jonathanw82/HydroBigTent/README.md

<h1 align="center">
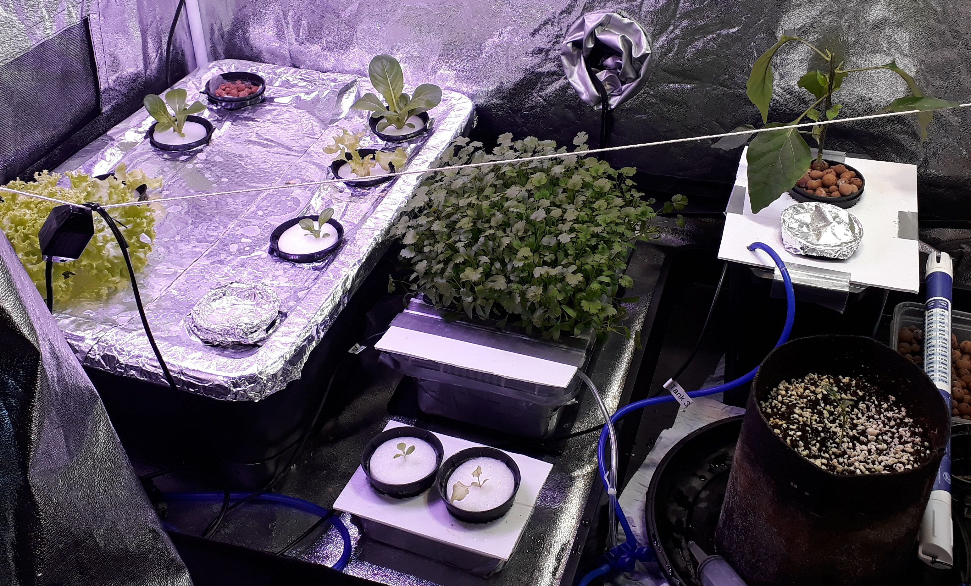
[picture p1: images/hydro1.jpg]
Hydro image
   
 </h1>
 
## Hydroponics

### I hold this project close to my heart, as it was my very first venture into coding, undertaken without any previous knowledge. The entire learning process, fueled by a book and Google, truly demonstrates how far I've advanced in my coding career from those initial steps to where I am today.

I created this Hydroponics system out of my love of mixing technology with nature, the ability to harness the building blocks of life to create tasty food in my dining room. This project is a work in progress but I am proud of the evolution of it.

The heart of the system is an Arduino Uno, connected to a real-time clock module, an LCD display and a rotary encoder. The Arduino controls lighting cycles, monitors water temperatures turning heat mats on if the water temperature is below its designated temperature. Whilst also keeping an eye on the time in case watering intervals have been reached and turning on pumps as necessary. The system can handle NFT and Ebb and flow style systems. During the creation of the system, I have made it able to have 2 tents with 2 individual lights that can be set to their own time cycles. The incorporation of a menu system and using EEprom to save settings was also implemented at this time.

When I first created the system, I originally used a compact fluorescent light, but I found if chews too much power to lumen ratio, I also tried to run the lights of a solid-state relay however being florescent, the solid-state relay made if flicker even when it was off, due to the way solid-state relay has a small but normal current flow through them that slowly charges up the capacitors in the fluorescent bulbs ballast and when they get to their minimum stating voltage the bulb with try to start but then die back dimply. To get around this, I used a standard relay, but due to the inrush current being 100+ times the operating current, the florescent bulb would fuse the relay terminals together not allowing the bulb to turn off, I even tried putting a snubber across the terminals but to no avail. At this point, I decided to go with a contractor as it is rated well over any spike in current the bulb could produce. Soon after, the florescent was replaced with the led bulbs in the second lighting fixture created out of individual bulbs that can be added or removed depending on the light intensity I needed for that particular application. More on lighting can be found here [Lighting](#lighting)

#### The user's goals of this system are:
* An easy to navigate menu
* Low power consumption
* Zero landfill
* Create great food fast

#### I think this system gives this to the user because:
* The rotary encoder is easy to use with one button click.
* The display cycles through current realtime data such as temperature and humidity.
* The entire system only takes 210 watts max.
* The system can use multiple types of hydroponic platforms such as Deep Water Culture, Nutrient Film Technique, Ebb and Flow etc.
* Due to the use of pool noodles, jiffy's, net cups, clay pebbles and coco, there is no Rockwool so zero landfill.

 ## Features:
* Rotary encoder for navigation
* Lcd display for easy and real-time data
* Realtime clock
* Led lights
* Silent running cooling fans
* Large quiet extractor fan [goto](#air-extraction)
* Silent running circulation fans
* Quiet air pump [goto](#air-pumps)
 
<div align="center">
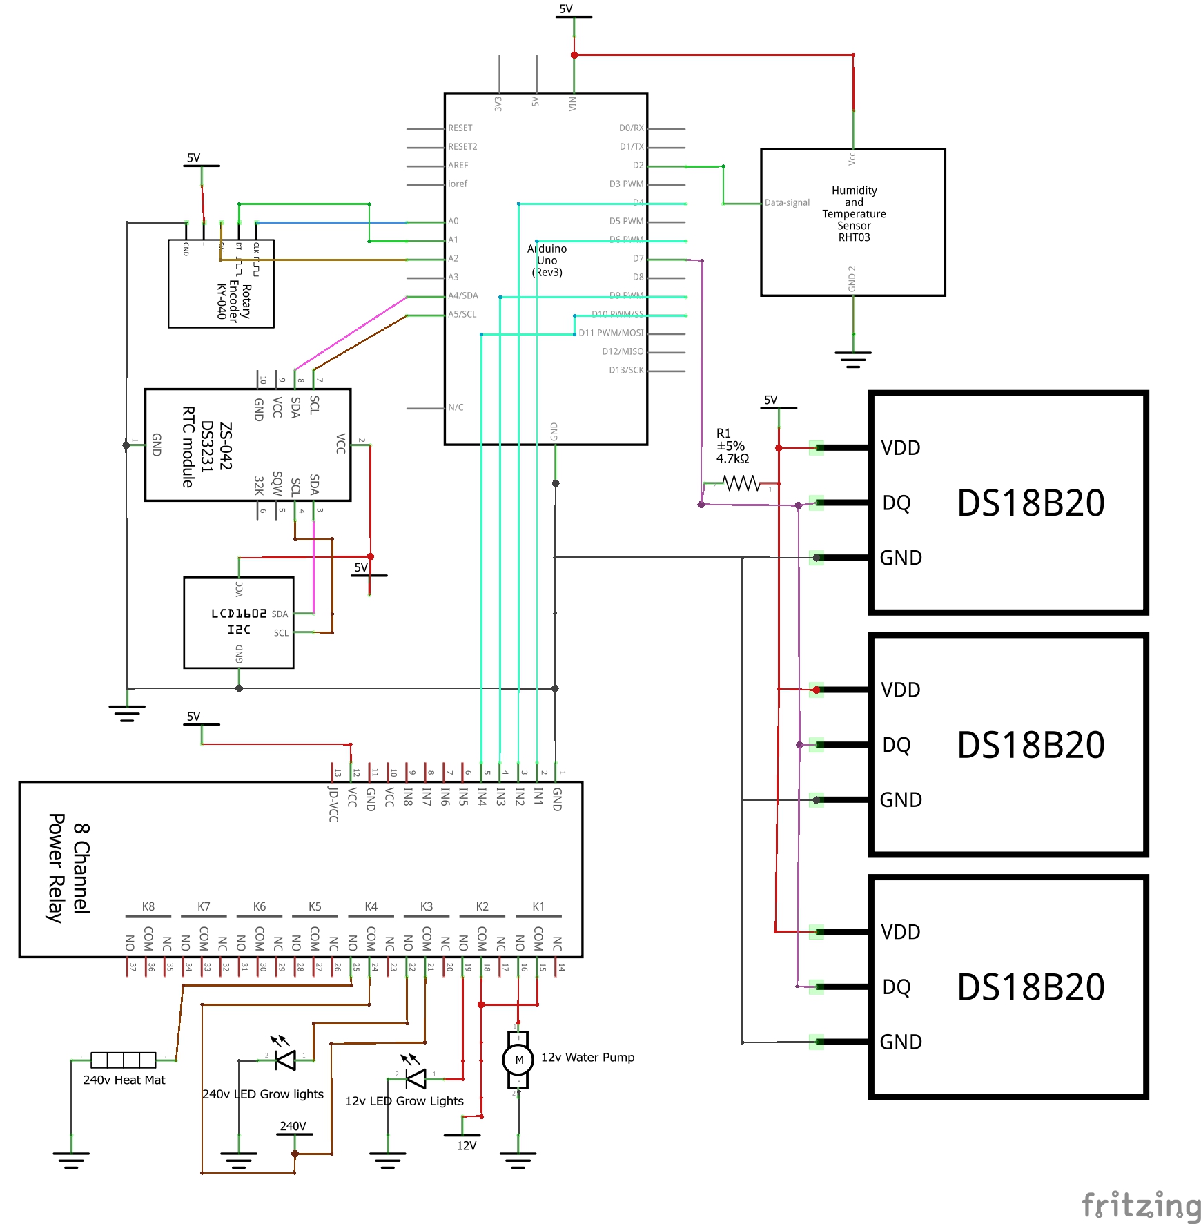
[picture p2: images/hydro_schem.jpg]
wireing diagram
   </div>

## Parts:
* 1x Arduino Uno (Rev3) [here](https://store.arduino.cc/arduino-uno-rev3)
* 1x RHT03 Humidity Temp Sensor [here](https://www.banggood.com/AM2302-DHT22-Temperature-And-Humidity-Sensor-Module-p-937403.html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)
* 3x DS18B20 Water temp sensors [here](https://www.cricklewoodelectronics.com/Waterproof-Digital-Temperature-Probe-for-Arduino-DS18B20.html) Unfortunatly there are not the ones in use currently.
* 1x KY-040 Rotery Encoder [here](https://www.cricklewoodelectronics.com/Rotary-encoder-module-for-Arduino-KY-040.html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) 
* 1x Lcd 1602i2c Display [here](https://create.arduino.cc/projecthub/Oniichan_is_ded/lcd-i2c-tutorial-664e5a)
* 1x Real Time clock Modual [here](https://uk.banggood.com/DS3231-AT24C32-IIC-Precision-RTC-Real-Time-Clock-Memory-Module-p-1547989.html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)
* 1x 4 channel realy [here](https://cpc.farnell.com/velleman-kit/vma400/4-channel-relay-module-for-arduino/dp/SC14419?mckv=sA419NTjI_dc|pcrid|224679642167|kword||match||plid||slid||product|SC14419|pgrid|47129782516|ptaid|pla-371255952663|&CMP=KNC-GUK-CPC-SHOPPING&gclid=EAIaIQobChMIssm7n_fl6QIVj-vtCh0o4Af9EAQYBSABEgLoQPD_BwE)
* 1x Contactor CUC20 [here](https://www.screwfix.com/p/british-general-20a-dp-contactor/6654p?_requestid=594347)
* 1x 5v 30amp Relay [here](https://robotdyn.com/relay-module-1-relay-5v-30a.html)
* 1x RK100 Can-fan [here](http://www.canfan.nl/cfrk100.html)
* 1x Acoustic air ducting [here](https://www.electrical2go.co.uk/insulated-aluminium-ducting-100mm-x-10m-fxalins-100.html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)
* 1x Grow tent
* 1x Eheim air pump 400 [here](https://www.eheim.com/en_GB/products/technology/air-pumps/air-400)
* 6x golf ball air stones and pipe.
* 25x growsun 3w Full spaectrum 380nm-840nm Led Chips [here](https://www.banggood.com/3W-380nm-840nm-Full-Spectrum-LED-Plant-Grow-Light-Chip-for-Garden-3_0-3_4V-p-1060934.html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)
* 15x High Power Led Chip 3W Cool White 3000K-3500K chips [here](https://www.lightinthebox.com/en/p/diy-3w-high-power-220-240lm-warm-white-light-led-module-3-2-3-6v-15pcs_p1549727.html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)
* 3x Noise Blocker 140mm fans [here](https://www.blacknoise.com/site/en/products/noiseblocker-it-fans/nb-eloop-series/120x120x25mm.php?lang=EN)

## Recycled parts:
* 1x 240v to 110v Auto Transformer [here](https://mcitransformer.com/product/mci-4-49-series/) From an old video game.
* 1x S-150-12 Switch mode power supply [here](https://uk.rs-online.com/web/p/embedded-switch-mode-power-supplies-smps/6210663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) from an old video game.
* 1x RD-65A Switch mode power supply [here](https://uk.rs-online.com/web/p/embedded-switch-mode-power-supplies-smps/6447102/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) From an old video game.
* 1x Aluminium sheet from the contol unit of a scap 2 penny pusher.
* 1x Heatsink from an old sega daytona video game graphics card.
* 2x storage boxes.
* Variouse other parts.

## Lcd Display:
<div align="center">
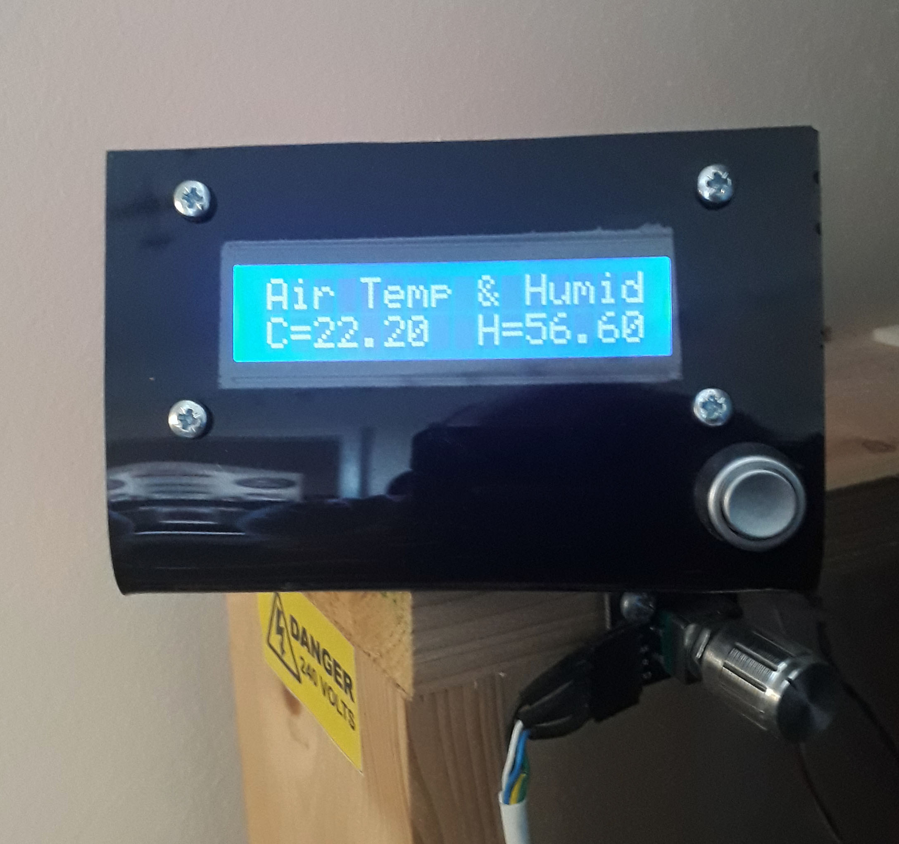
[picture p3: images/lcd.jpg]
topof image
</div>

#
During day to day running the LCD display scrolls through a few screens of data including
* Time and date 
* Air temperature and humidity
* The big tank water temperature
* Tank 2 water temperature
* Tank 3 water temperature
* Heat pad status
* Light cycle for the 12v led panel
* Light cycle for the 240v led bulbs

### Setup program flow:
On pressing the rotary encoder centre button
* Lighting time 240v lights, on click, will give a menu allowing selection of 0, 12, 14, 16, 18 hours duration.
* Lighting time 12v lights, on click, will give a menu allowing selection of 0, 12, 14, 16, 18 hours duration.
* Watering duration, on click, will give a menu allowing selection of between 5 and 90 seconds in 0.5 increments duration.
* Watering time, on click, will give a menu allowing selection of auto water off, or if rotated to the right you can select what hour you would like to start watering. If at the auto water off selection if the encoder is rotated further left a selection to turn on NFT will appear. Further adjustment to NFT can be done in the next menu.
* NFT with cycle, on click, will give a menu allowing selection of on duration and off duration in minutes.
* Manual water, on click, will give a menu allowing selection manual overriding the water pump, in case of now plants needing an initial dousing of nutrient feed.
* Daylight saving, on click, will give a menu allowing selection of plus or minus 1 hour. This only affects the clock on the LCD display and will not change the global watering or lighting cycles due to some plants being sensitive to changes in lighting durations.
* Heat pad temperature settings, on click, will give a menu allowing the max temperate of the heat mate from 0 to 25 degrease centigrade.
* Exit menu
* If the centre button on the encoder is held down it will cause the Arduino to rest by kicking the watchdog, this can be done regardless of being in setup mode.

## Lighting
The 12v lighting panel was made up of a piece of aluminium from the lid of a 2 penny pusher control box, with a heat sink from a Sega Daytona video game and stuck to the top with thermal glue. At first, I wanted the cooling to be passive, but there were too many led chips in close proximity, so I had to add a fan, most of the early fans I used were really loud or vibrated too much, so I added a noise blocker fan as they produce 178.3 m3/h @28.5db so it was a good compromise.   
#
<div align="center">
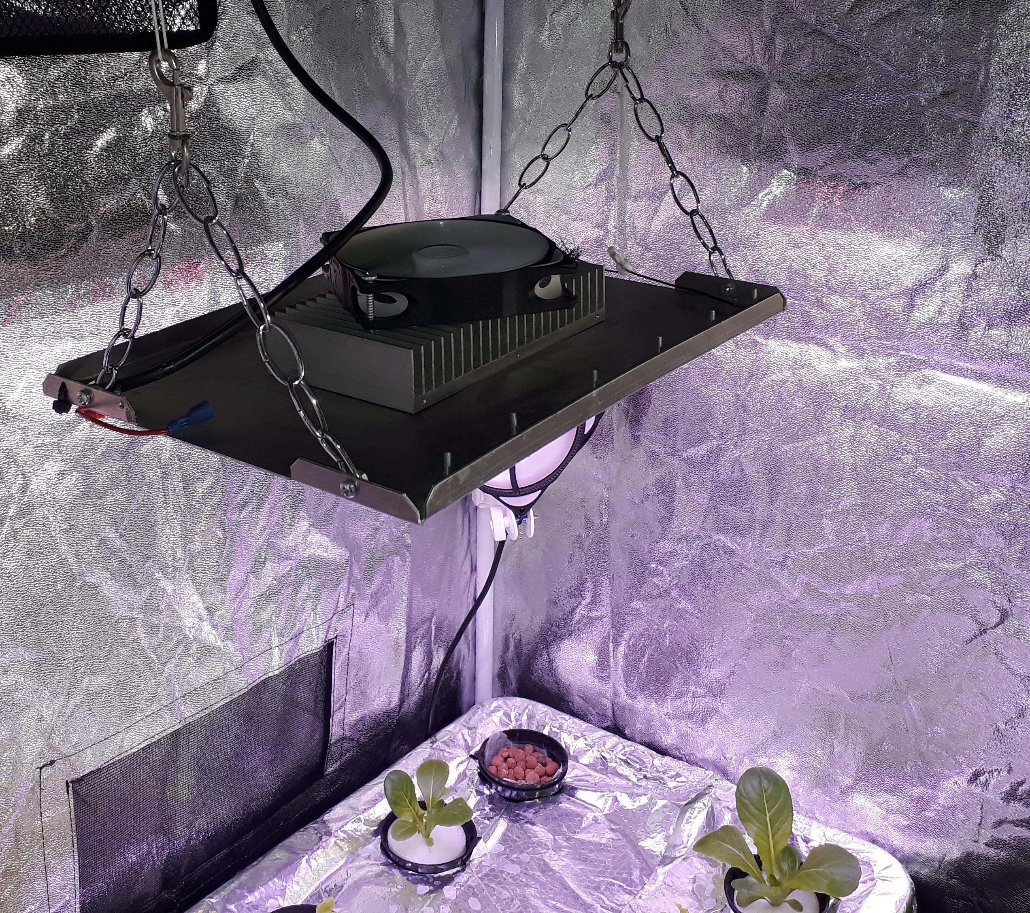
[picture p4: images/lightwithfan.jpg]
topof image
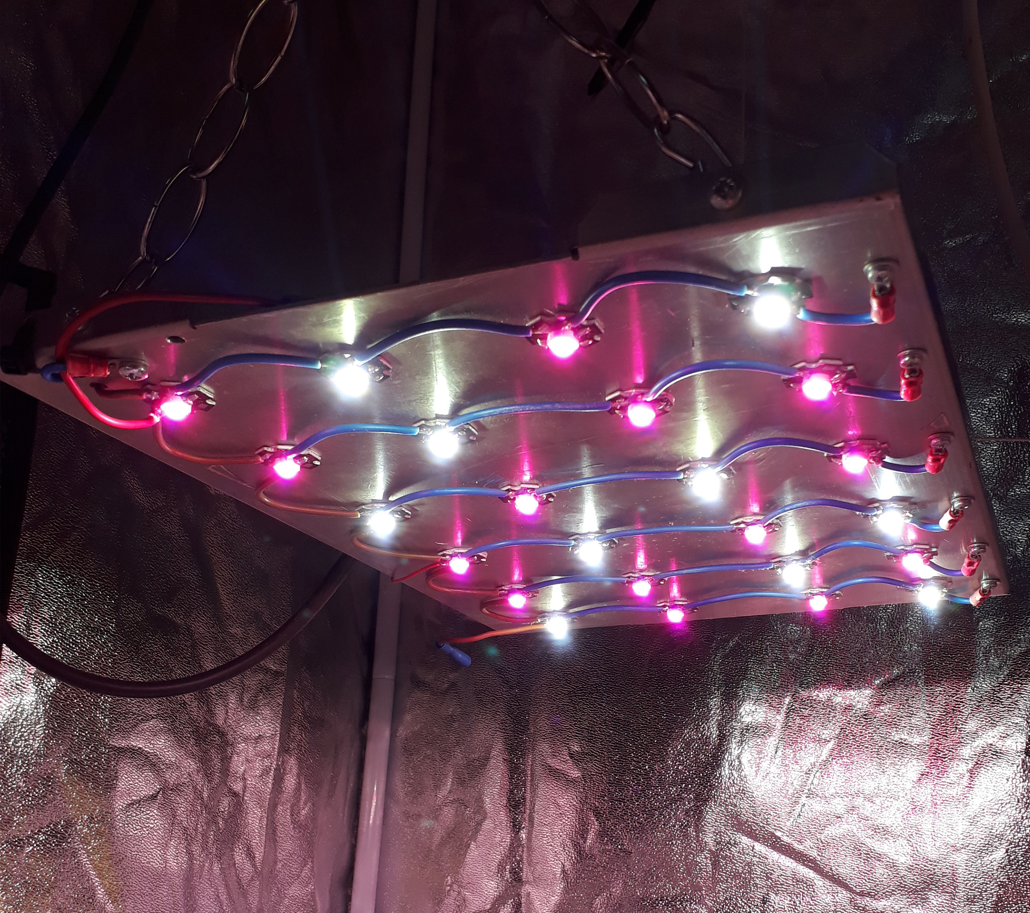
[picture p5: images/leds.jpg]
led image
 </div>

#
The first version only had the Growsun led grow lights giving a pink colour due to the colour spectrum from blue 320nm and the red 840nm with nothing much else, while plants did grow, I found they became leggy and unable to hold their own weight.  
#

<div align="center">
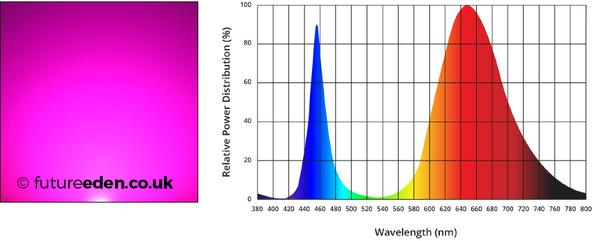
[picture p6: images/fullspectrum.jpg]
light spectrum image
   
 </div>

#
After some time googling, I found that even though plants don’t need yellow and green light for photosynthesis, there is some debate around whether green light helps the plants push toxins out of the leaves, I have no clue if this is true however, I decided to add some warm white LEDs to cover more of the visible light spectrum, even though some people will argue this is a waste of energy, however, due to the wavelengths favouring the red end of the spectrum, the plants started to bolt early. At this point I changed them for cool white LEDs, the difference was amazing and the plants shot into life, woodier stems and healthy-looking leaves.

#
 <div align="center">
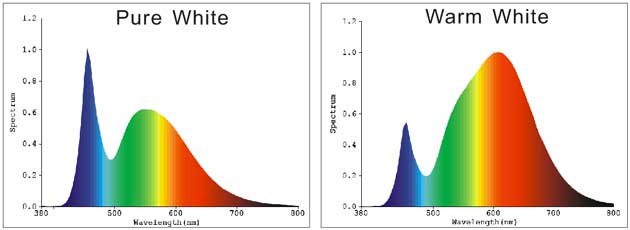
[picture p7: images/Warm_vs_Cool_White-1.jpg]
light spectrum image
   
 </div>
 
#
I created a second lighting fixture as I needed more light but was unable to get any of the scrap parts I had used previously, so I had to improvise with the intention it would be replaced in a few months with something better, 3 years on I’m still using it. Created from a cardboard box and tinfoil with 6x 240v bulb holders and a light switch, I used a mix of warm white and daylight 240v led [bulbs](https://www.lampshoponline.com/12-5w-energizer-led-gls-6500k-b22-s9427.html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) that emit almost no heat, so any concern there were eliminated, I have had multiple chilli plants and peppers flower underneath no problems.
#

<div align="center">
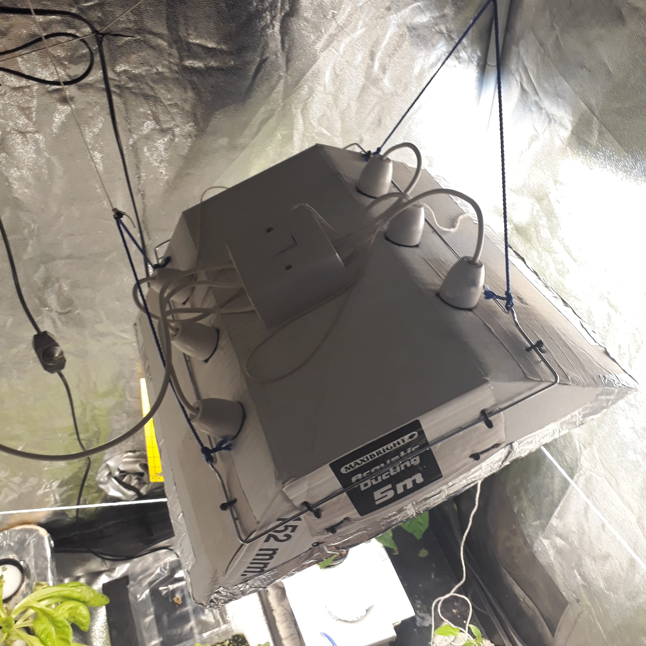
[picture p8: images/20200603_195337.jpg]
240v lights image
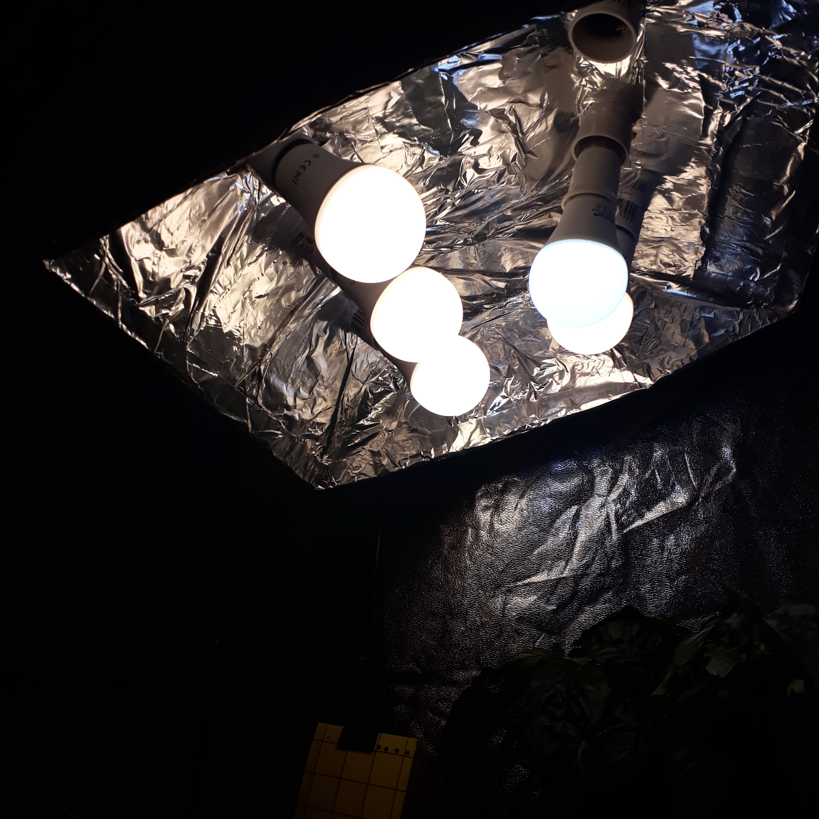
[picture p9: images/20200603_195402.jpg]
240v lights image
 </div>
<div align="center">
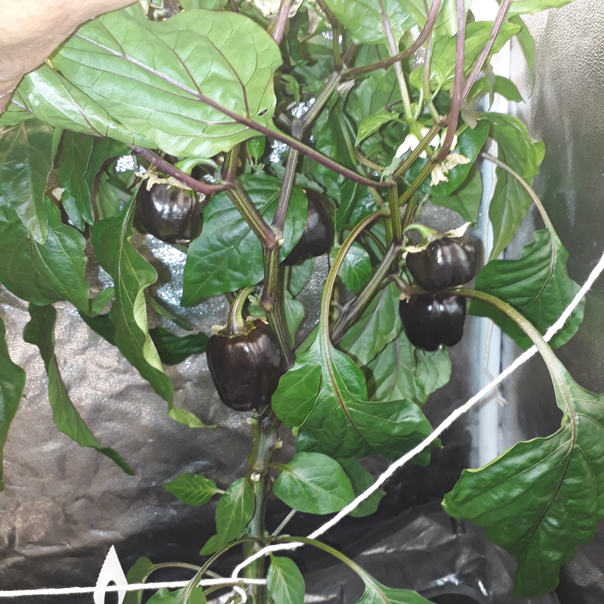
[picture p10: images/20200603_195506.jpg]
peppers image
 </div>

[Back_to_top](#Hydroponics)

## Air Extraction:
I chose the RK100 Can-fan, as at the time was the most affordable, however, early on I realised it was far too powerful for what I needed as the tent caved in on itself when at full speed, it also made quite some noise, originally I put a cheap fan speed controller on it but due to the crude way they chop the alternating current waveform it made the fan hum and drone. A proper speed controller was too expensive for the project. I did realise that half-speed was ideal, so I swapped out the fan speed controller for a 110v transformer I recycled from an old video game and it was a perfect extraction rate running the fan at 110v instead of 240v.

I could have used the Arduino on a Pulse Width Modulation (PWM) channel with a solid-state relay to regulate the fan speed but I was running out of space on the EEPROM as it was.

## Air Pumps
During the early stages I tried multiple types of systems from Deep Water Culture to NFT and in the end, settles for Deep Water Culture, I was originally using a really small air pump and noticed that the plants were lagging in something, especially in the summer months when the water temperature is close to 23degrees centigrade, I soon learned that the oxygen levels in the water drop depending on temperature, so I went for the Eheim 400 air pump its fantastic, quiet and powerful enough for this application.

## Growroom tools:
My tools of choice when it comes to making nutrient solution:
* Bluelab Truncheon for testing the TDS/EC [here](https://bluelab.com/bluelab-commercial-truncheon-nutrient-meter)
* HM Digital PH-80 for testing PH [here](http://hmdigital.com/product/ph-80/)

## Nutrients:
The nutrients that have become stapes in my grow room
### Seedlings
* Growth Technology Formulex [here](https://www.growthtechnology.com/product/formulex/)
* Atami Rootbastic [here](https://grownuphydroponics.com/atami-rootbastic-explosive-root-growth-first-3-weeks-concentrated.html)
* Atami Silic Boost [here](https://grownuphydroponics.com/b-cuzz-silic-boost-concentrated-silicon-atami.html)
* Growth Technology Clonex [here](https://www.growthtechnology.com/product/clonex/)
### Mature plants
* Growth Technology Ionic Hydro Hard Water Grow [here](https://www.growthtechnology.com/product/ionic-hydro-hard-water-grow/)
* Growth Technology Ionic Hydro Hard Water Bloom [here](https://www.growthtechnology.com/product/ionic-hydro-hard-water-bloom/)
* Growth Technology Ionic Coco Grow [here](https://www.growthtechnology.com/product/ionic-for-coco-grow/)
* Growth Technology Ionic Coco Bloom [here](https://www.growthtechnology.com/product/ionic-for-coco-bloom/)
* Growth Technology Chilli Focus [here](https://www.growthtechnology.com/product/chilli-focus/)
* Atami Silic Boost [here](https://grownuphydroponics.com/b-cuzz-silic-boost-concentrated-silicon-atami.html)
* Atami Rootbastic [here](https://grownuphydroponics.com/atami-rootbastic-explosive-root-growth-first-3-weeks-concentrated.html)
* Atami Bloombastic [here](https://grownuphydroponics.com/atami-bloombastic-explosive-flower-growth-weeks-4-6-concentrated.html)
* Canna Pk 13/14 [here](https://www.canna-uk.com/pk_13_14)
* Silver Bullet Roots [here](https://www.growell.co.uk/pest-control-plant-health/disease-control/silver-bullet-roots.html)
* CalMag [here](https://www.canna-uk.com/calmag-agent)
* PH Down [here](https://www.growthtechnology.com/product/ph-down/)
### Pests
* Pyrethrum 5EC [here](https://www.pelgar.co.uk/product/pyrethrum-5-ec/)
* SB Plant Invigorator [here](https://sbproducts.co.uk/)

## Nice to have: 
These features may be included in future releases of this application.
* Digital extraction fans
* Higher power led lighting
* Air conditioning
* Water cooler

## Bugs & ongoing fixes
* The rotary encoder can be laggy and need quite a few revolutions to get get to where the user needs to be in the menu.
* The water temp sensors are cheap and their output is erratic this can cause the heater pad relays to chatter if the target temperature is close. To get around this I have added if statements to look to see if the temperature being read is equal to -127 (-127 meaning no output) in future releases I will get better quality sensors.

### Credits:
I would like to thank my friend Cersnic Tibor for his help with this project.

The ideas for the menu system came from here 
http://educ8s.tv/arduino-rotary-encoder-menu/

##### Media:

Images of light wave lengths
https://thegreensunshineco.com/think-beyond-white-led-and-bulb-grow-lights-kelvin-and-color-temperature/

Image of Full spectrum wave length
https://futureeden.co.uk/

All other images are my own.

[Back_to_top](#Hydroponics)
