jonathanw82/HydroBigTent/Current_HYDRO_BIGTENTver9/Display.ino

void Display() {

  if (menuEntered == 1) {}
  else {
    // ~~~~~~~~~~~~~~~~~~~~~~~~~ LCD DISPLAY DATA ~~~~~~~~~~~~~~~~~~~~~~~~~~~~~~ 1 Screen
    if (page == 1 && menuitem == 1 && menuEntered == 0 ) {


      if (currentTime - previousTime >= 2000 && marker == 0)
      {
        previousTime = currentTime;
        lcd.clear();
        lcd.setCursor(0, 0);
        lcd.print(F("Hydroponics Data"));
        lcd.setCursor(0, 1);
        lcd.print(F(" By Jon Wheway"));
        marker = marker + 1;
      }

      // ~~~~~~~~~~~~~~~~~~~~~~~~~~~~~ TIME AND DATE ~~~~~~~~~~~~~~~~~~~~~~~~~~~~~~ 2 Screen
      if (currentTime - previousTime >= 2000 && marker == 1)
      {
        previousTime = currentTime;
        DateTime now = rtc.now();
        lcd.clear();
        lcd.setCursor(0, 0);
        lcd.print(F("Time & Date"));
        lcd.setCursor(0, 1);
        if (DaylightSaving == 1) {
          if (now.hour() == 00) {
            lcd.print("00");
            lcd.print(F(":"));
            lcd.print(now.minute());
            lcd.print(F(" "));
          }
          else {
            sprintf(dateBuffer, "%02u:%02u ", now.hour() - 1, now.minute());
            lcd.print(dateBuffer);
          }
        }
        if (DaylightSaving == 0) {
          sprintf(dateBuffer, "%02u:%02u ", now.hour(), now.minute());
          lcd.print(dateBuffer);
        }
        sprintf(dateBuffer, "%02u-%02u-%04u ", now.day(), now.month(), now.year());
        lcd.print(dateBuffer);
        marker = marker + 1;
      }

      // ~~~~~~~~~~~~~~~~~~~~~~~ AIR TEMPERATURE AND HUMIDITY ~~~~~~~~~~~~~~~~~~~~~ 3 Screen

      if (currentTime - previousTime >= 4000 && marker == 2)
      {
        previousTime = currentTime;
        /*
          Serial.println("Air Temp & Humid");
          Serial.print ("C=");
          Serial.println (temp);
          Serial.print ("H=");
          Serial.print (hum);
          Serial.println("%");
        */
        lcd.clear();
        lcd.setCursor(0, 0);
        lcd.print(F("Air Temp & Humid"));
        lcd.setCursor(0, 1);
        lcd.print(F("C="));
        lcd.print(temp);
        lcd.print(F("  H="));
        lcd.print(hum);
        lcd.print(F("%"));
        marker = marker + 1;
      }



      //~~~~~~~~~~~~~~~~~~~~~~~~~~~~~ WATER TEMPERATURE ~~~~~~~~~~~~~~~~~~~~~~~~~~~ 4 Screen

      if (currentTime - previousTime >= 4000 && marker == 3)
      {
        previousTime = currentTime;
        lcd.clear();
        lcd.setCursor(0, 0);
        lcd.print(F("Temp BigTank"));
        lcd.setCursor(0, 1);
        lcd.print(F("C="));
        lcd.print(SensorWater1TrueRead);           // Why "byIndex"? You can have more than one IC on the same bus 0 refers to the first IC on the wire

        marker = marker + 1;
      }

      if (currentTime - previousTime >= 4000 && marker == 4)
      {
        previousTime = currentTime;
        lcd.clear();
        lcd.setCursor(0, 0);
        lcd.print(F("Temp Tank 2"));
        lcd.setCursor(0, 1);
        lcd.print(F("C="));
        lcd.print(SensorWater2TrueRead);           // Why "byIndex"? You can have more than one IC on the same bus 0 refers to the first IC on the wire

        marker = marker + 1;
      }
      if (currentTime - previousTime >= 4000 && marker == 5)
      {
        previousTime = currentTime;
        lcd.clear();
        lcd.setCursor(0, 0);
        lcd.print(F("Temp Tank 3"));
        lcd.setCursor(0, 1);
        lcd.print(F("C="));
        lcd.print(SensorWater3TrueRead);           // Why "byIndex"? You can have more than one IC on the same bus 0 refers to the first IC on the wire

        marker = marker + 1;
      }

      if (currentTime - previousTime >= 4000 && marker == 6)
      {
        previousTime = currentTime;
        lcd.clear();
        lcd.setCursor(0, 0);
        lcd.print(F("Heat Mat Status "));
        lcd.setCursor(0, 1);
        if (HeatPadStatus == 1) {
          lcd.print(F("Heat Mat Off   "));
        }
        else {
          lcd.print(F("Active!   "));
        }
        marker = marker + 1;
      }


      //~~~~~~~~~~~~~~~~~~~~~~~~~~~~~~ Light Cycle ~~~~~~~~~~~~~~~~~~~~~~~~~~~~~~~ 5 Screen

      if (currentTime - previousTime >= 2000 && marker == 7)
      {
        previousTime = currentTime;
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
    lcd.print(lightingHour);
    lcd.setCursor(1, 1);
    lcd.print(F("  0  1  2  3  4"));
  }
  if ( menuitem == 4 && page == 1 && menuEntered == 1)
  {
    lcd.setCursor(0, 0);
    lcd.print(F("Lighting Veg    "));
    lcd.setCursor(0, 1);
    lcd.print(F("Click to Enter  "));
  }

  if (menuitem == 4 && page == 2 && menuEntered == 1) {
    lcd.setCursor(0, 0);
    lcd.print(F("   X 12 14 16 18"));
    lcd.setCursor(0, 1);
    lcd.print(VeglightingHour);
    lcd.setCursor(1, 1);
    lcd.print(F("  0  1  2  3  4"));
  }

  if (menuitem == 5 && page == 1 && menuEntered == 1)
  {
    lcd.setCursor(0, 0);
    lcd.print(F("Water Duration  "));
    lcd.setCursor(0, 1);
    lcd.print(F("Click to Enter  "));
  }

  if (menuitem == 5 && page == 2 && menuEntered == 1)
  {

    lcd.setCursor(0, 0);
    lcd.print(F("Set Duration    "));
    lcd.setCursor(0, 1);
    lcd.print(water);
    lcd.setCursor(2, 1);
    lcd.print(F(" Seconds      "));

    if (water < 10) {
      lcd.setCursor(1, 1);
      lcd.print(F(" "));
    }

  }
  if (menuitem == 6 && page == 1 && menuEntered == 1)
  {
    lcd.setCursor(0, 0);
    lcd.print(F("Watering Time       "));
    lcd.setCursor(0, 1);
    lcd.print(F("Click to enter      "));
  }
  if (menuitem == 6 && page == 2 && menuEntered == 1)
  {

    if (WateringTime == 0)
    {
      lcd.setCursor(0, 0);
      lcd.print(F("Auto Watering   "));
      lcd.setCursor(0, 1);
      lcd.print(F("Auto OFF        "));
    }
    else if (WateringTime == -1) {
      lcd.setCursor(0, 0);
      lcd.print(F("NFT Watering    "));
      lcd.setCursor(0, 1);
      lcd.print(F("NFT ON use setup"));
    }
    else {
      lcd.setCursor(0, 0);
      lcd.print(F("Set in 24h Clock"));
      lcd.setCursor(0, 1);
      lcd.print(F("     "));

      if (WateringTime < 10) {
        lcd.setCursor(5, 1);
        lcd.print(F("0"));
        lcd.print(WateringTime);

      }
      else if (WateringTime >= 10) {
        lcd.setCursor(5, 1);
        lcd.print(WateringTime);
      }
      lcd.setCursor(7, 1);
      lcd.print(F(":00     "));
    }
  }
  if (menuitem == 7 && page == 1 && menuEntered == 1)
  {
    lcd.setCursor(0, 0);
    lcd.print(F("NFT with Cycle  "));
    lcd.setCursor(0, 1);
    lcd.print(F("Click to setup  "));
  }
  if (menuitem == 7 && page == 2 && menuEntered == 1)
  {
    lcd.setCursor(0, 0);
    lcd.print(F("NFT    ON   OFF"));
    lcd.setCursor(0, 1);
    lcd.print(F("Mins  ="));
    lcd.setCursor(7, 1);
    lcd.print(NFTrunTime);
    lcd.setCursor(9, 1);
    lcd.print(F("   "));
    lcd.setCursor(12, 1);
    lcd.print(NFTDelay);

    if (NFTrunTime < 10) {
      lcd.setCursor(7, 1);
      lcd.print("0");
      lcd.print(NFTrunTime);
    }
    if (NFTrunTime >= NFTDelay) {
      NFTrunTime -= 5;
    }
  }
  if (menuitem == 7 && page == 3 && menuEntered == 1)
  {
    lcd.setCursor(0, 0);
    lcd.print(F("NFT    ON   OFF"));
    lcd.setCursor(0, 1);
    lcd.print(F("Mins   "));
    lcd.setCursor(7, 1);
    lcd.print(NFTrunTime);
    lcd.setCursor(9, 1);
    lcd.print(F("  ="));
    lcd.setCursor(12, 1);
    lcd.print(NFTDelay);

    if (NFTrunTime < 10) {
      lcd.setCursor(7, 1);
      lcd.print("0");
      lcd.print(NFTrunTime);
    }

    if (NFTDelay <= NFTrunTime ) {
      NFTDelay += 10;
    }
  }

  if (menuitem == 8 && page == 1 && menuEntered == 1)
  {
    lcd.setCursor(0, 0);
    lcd.print(F(" Manual Water   "));
    lcd.setCursor(0, 1);
    lcd.print(F(" Click To Enter "));
  }
  if (menuitem == 8 && page == 2 && menuEntered == 1)
  {
    lcd.setCursor(0, 0);
    lcd.print(F(" Pump On/Off    "));
    lcd.setCursor(0, 1);
    if (manWater == 1) {
      lcd.print(F(" Pump Running "));
    }
    if (manWater == 0) {
      lcd.print(F(" Pump OFF      "));
    }
  }
  if (menuitem == 9 && page == 1 && menuEntered == 1)
  {
    lcd.setCursor(0, 0);
    lcd.print(F("Daylight Saving "));
    lcd.setCursor(0, 1);
    lcd.print(F(" Click To Enter "));
  }
  if (menuitem == 9 && page == 2 && menuEntered == 1)
  {
    lcd.setCursor(0, 0);
    lcd.print(F("Daylight Saving  "));
    lcd.setCursor(0, 1);
    lcd.print(F("  -1 hour "));
    lcd.setCursor(10, 1);
    lcd.print(DaylightSaving);
    lcd.print(F("      "));

  }
  if (menuitem == 10 && page == 1 && menuEntered == 1)
  {
    lcd.setCursor(0, 0);
    lcd.print(F("Heat Pad Temp   "));
    lcd.setCursor(0, 1);
    lcd.print(F("Click to setup  "));
  }
  if (menuitem == 10 && page == 2 && menuEntered == 1)
  {
    lcd.setCursor(0, 0);
    lcd.print(F("HeatPad Max Temp"));
    lcd.setCursor(0, 1);
    lcd.print(F("C= "));
    lcd.setCursor(3, 1);
    lcd.print(heatPadTemp);
    lcd.setCursor(8, 1);
    lcd.print(F("        "));

    if (heatPadTemp < 10) {
      lcd.setCursor(7, 1);
      lcd.print(F(" "));
    }
  }
  if (menuitem == 11 && page == 1 && menuEntered == 1)
  {
    lcd.setCursor(0, 0);
    lcd.print(F(" To Exit Menu   "));
    lcd.setCursor(0, 1);
    lcd.print(F(" Click To Exit  "));
  }
}
