jonathanw82/HydroBigTent/Current_HYDRO_BIGTENTver9/Debug.ino

void Debug(){
  // ~~~~~~~~~~~~~~~~~~~~~~~~~~~~~~~~  DeBug outputs on Serial ~~~~~~~~~~~~~~~~~~~~~~~~~~~~~~~~~~~~~~

  //  Serial.print(" Encoder Value =");
  //  Serial.println(value);
  //  Serial.print(" Menu Item Number =");
  //  Serial.println(menuitem);
  //  Serial.print(" page num=");
  //  Serial.println(page);
  //  Serial.print(" Menu Entered=");
  //  Serial.println(menuEntered);
  //  Serial.print(" Enter=");
  //  Serial.println(enter);
  //  Serial.print("NFT RunTime=");
  //  Serial.println(NFTrunTime);
  //  Serial.print(" NFT Delay=");
  //  Serial.println(NFTDelay);
  //  Serial.print(" Watering Time");
  //  Serial.println(WateringTime);
  //  Serial.print(" NFT Run Interval =");
  //  Serial.println(NFTrunInterval);
  //  Serial.print(" NFT Delay Interval =");
  //  Serial.println(NFTDelayPause);
  //  Serial.print(" veg Light time =");
  //  Serial.println(VeglightingHour);
  //  Serial.print(" DaylightSaving =");
  //  Serial.println(DaylightSaving);
  //  Serial.print(" Heat Pad Temp =");
  //  Serial.println(heatPadTemp);
  //  Serial.print(" Heat Pad Status =");
  //  Serial.println(HeatPadStatus);
  //  Serial.print(" Temp Swing =");
  //  Serial.println(HeatPadTempSwing);
  //  Serial.println(" Small Tank Temp =");
  //  Serial.print (sensors.getTempCByIndex(1));
  //  Serial.print(F(" Checking Water Temp small Tank = "));
  //  Serial.print(sensors.getTempCByIndex(0));
  //  Serial.print(F(" Checking Water Tank 3 = "));
  //  Serial.println(SensorWater2TrueRead);
}
